GadgetReboot/GR_555_Controller/README.md

# GR_555_Controller
Controlling 555's using digital pots over I2C
