GadgetReboot/GR_555_Controller/GR_555_Controller_Sch.pdf

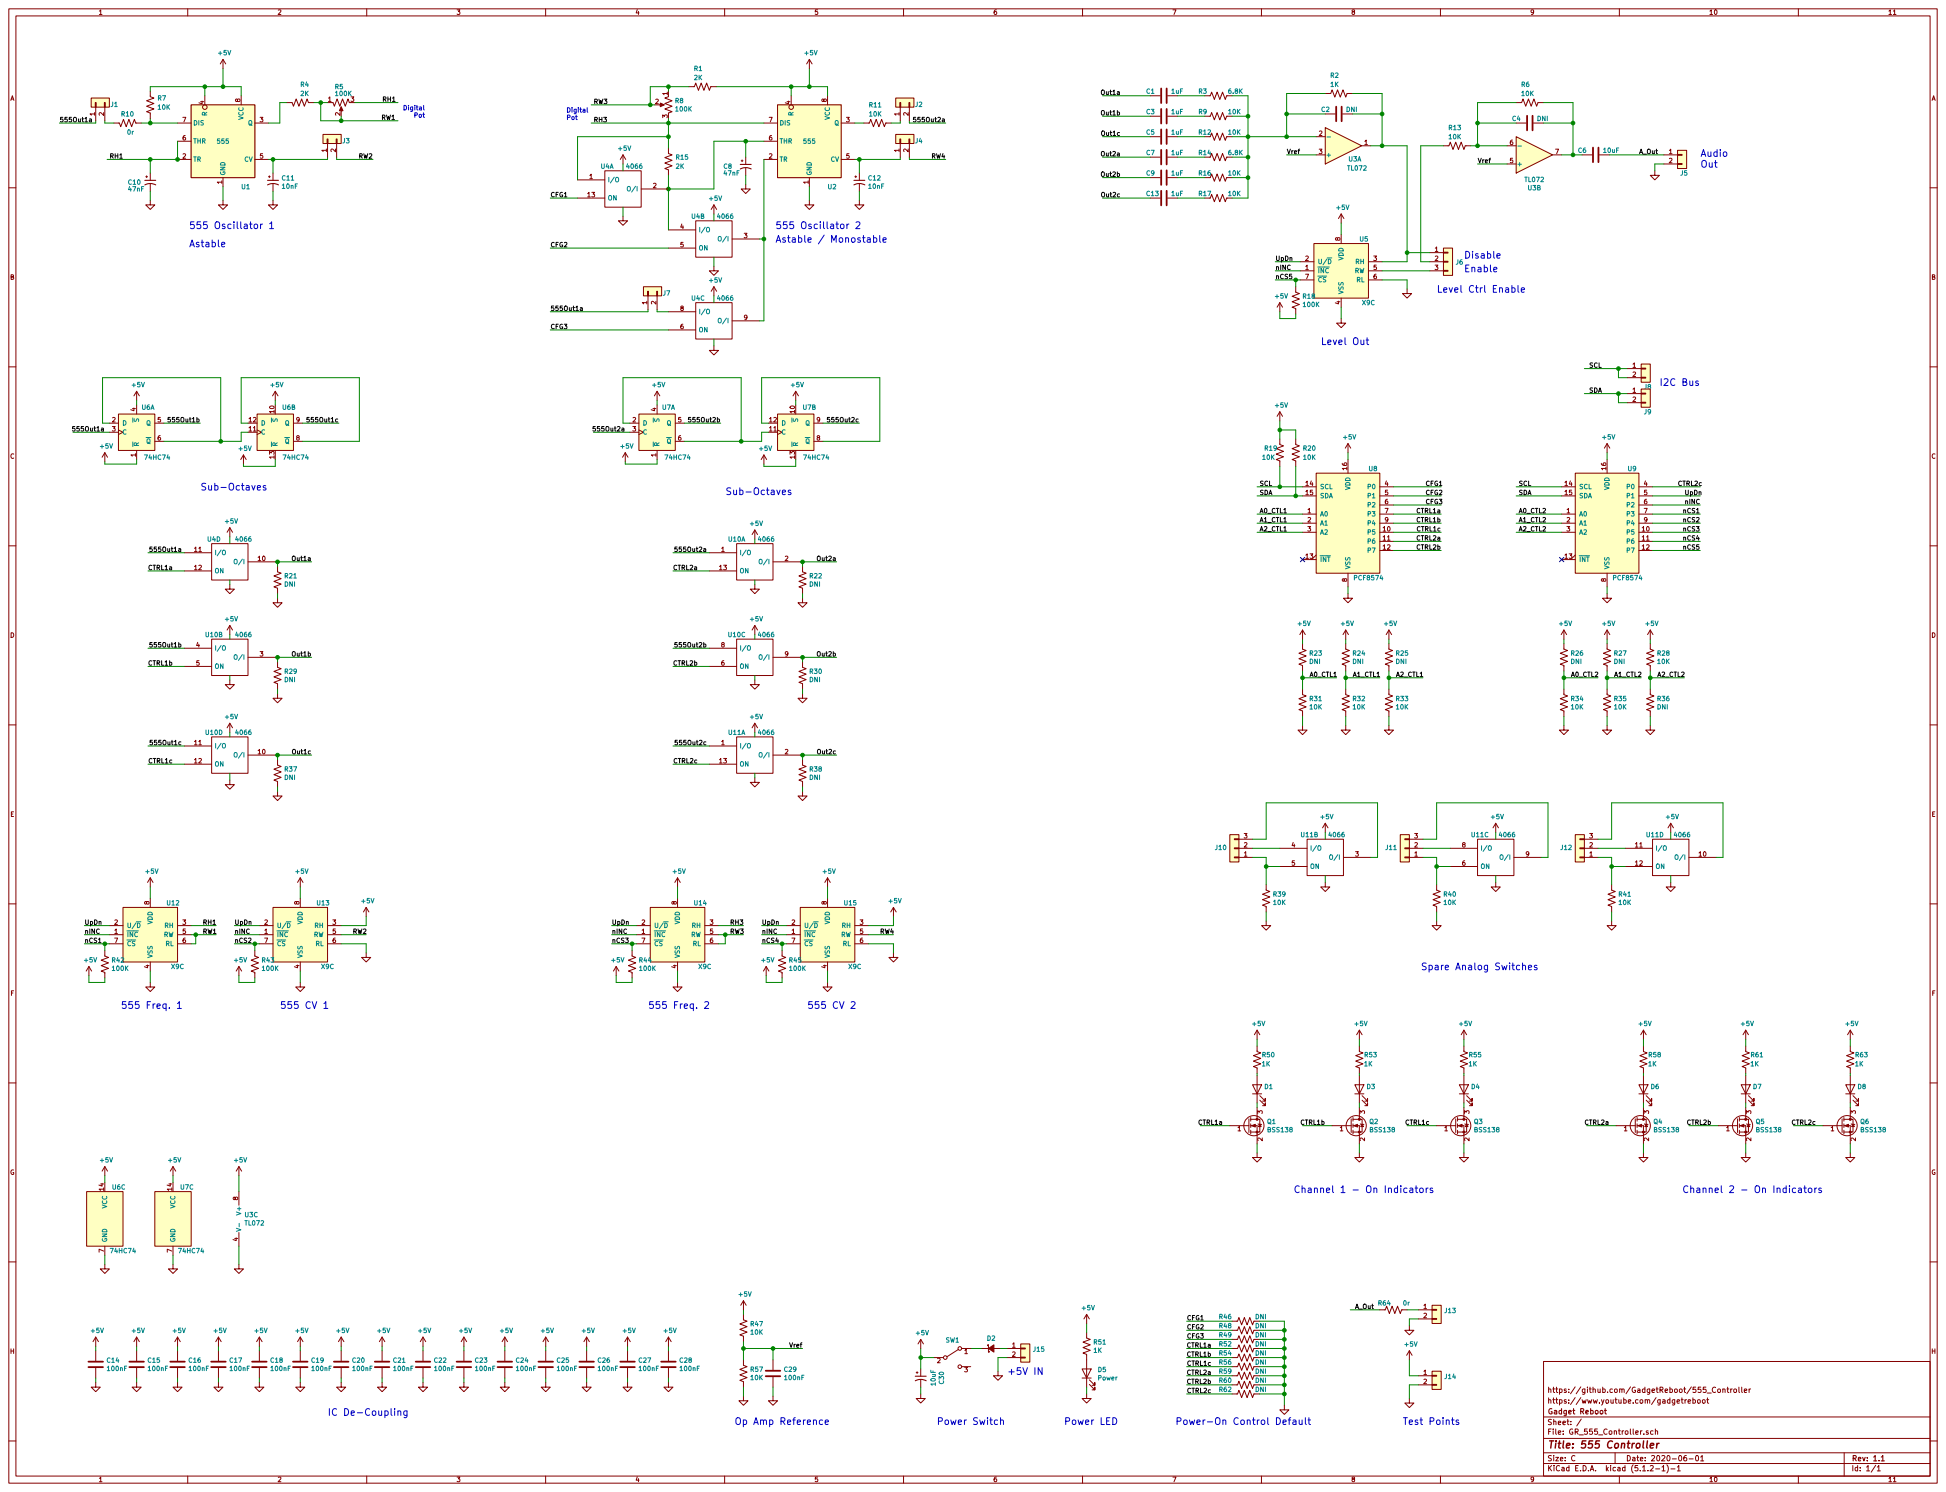
[picture p1: page 1]

4 RW 5 RL 6 CS 7 VDD

https://github.com/GadgetReboot/555_Controller R51
1KD5Power

https://www.youtube.com/gadgetreboot
File: GR_555_Controller.sch Sheet: / Gadget Reboot
