GadgetReboot/GR_555_Controller/KiCAD/GR_555_Controller.kicad_pcb

## KiCad design KiCAD/GR_555_Controller.kicad_pcb (2020-06-03)

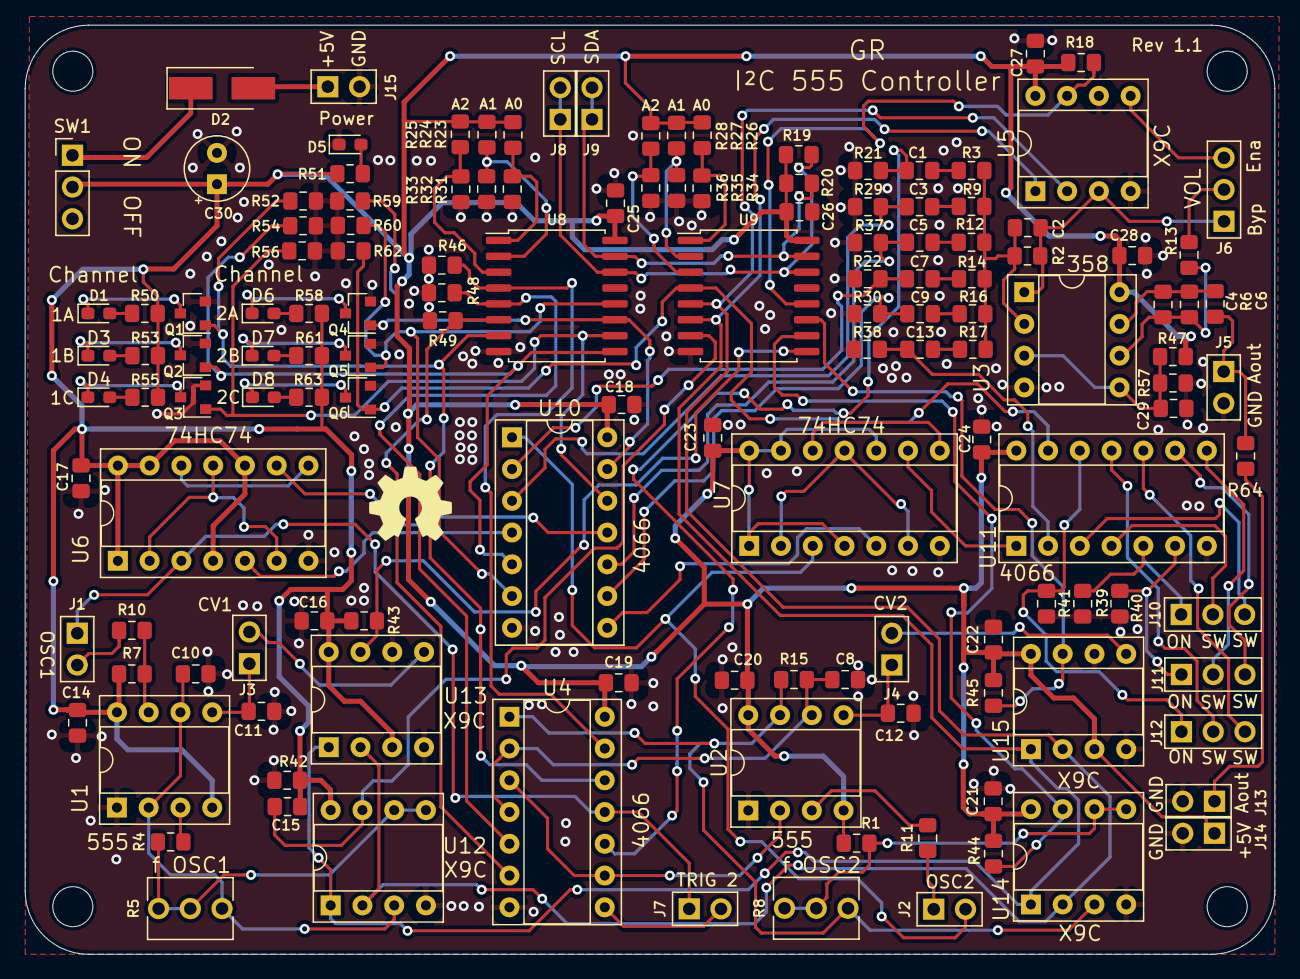
[picture p2: board GR_555_Controller.kicad_pcb from above]

Board: 2 copper layers, 99.9 x 74.3 mm, 139 parts (0 on the bottom side), 97 nets.

Parts:
C1, C3, C5, C7, C9, C13: 1uF; C_0805_2012Metric_Pad1.15x1.40mm_HandSolder
C2, C4: DNI; C_0805_2012Metric_Pad1.15x1.40mm_HandSolder
C6: 10uF; C_0805_2012Metric_Pad1.15x1.40mm_HandSolder
C8, C10: 47nF; C_0805_2012Metric_Pad1.15x1.40mm_HandSolder
C11, C12: 10nF; C_0805_2012Metric_Pad1.15x1.40mm_HandSolder
C14, C15, C16, C17, C18, C19, C20, C21, C22, C23, C24, C25, C26, C27, C28, C29: 100nF; C_0805_2012Metric_Pad1.15x1.40mm_HandSolder
C30: 10uF; CP_Radial_Tantal_D5.0mm_P2.50mm
D1, D3, D4, D6, D7, D8: LED; LED_0603_1608Metric_Pad1.05x0.95mm_HandSolder
D2: D_Schottky_Small_ALT; D_SMA_Handsoldering
D5: Power; LED_0603_1608Metric_Pad1.05x0.95mm_HandSolder
J1, J2, J3, J4, J5, J7, J8, J9, J13, J14, J15: 1x2; PinHeader_1x02_P2.54mm_Vertical_H1.0mm
J6, J10, J11, J12: Conn_01x03; PinHeader_1x03_P2.54mm_Vertical_H1.0mm
Q1, Q2, Q3, Q4, Q5, Q6: BSS138; SOT-23
R1, R4, R15: 2K; R_0805_2012Metric_Pad1.15x1.40mm_HandSolder
R2, R50, R51, R53, R55, R58, R61, R63: 1K; R_0805_2012Metric_Pad1.15x1.40mm_HandSolder
R3, R14: 6.8K; R_0805_2012Metric_Pad1.15x1.40mm_HandSolder
R5, R8: 100K; Potentiometer_Green
R6, R7, R9, R11, R12, R13, R16, R17, R19, R20, R28, R31, R32, R33, R34, R35, R39, R40, R41, R47, R57: 10K; R_0805_2012Metric_Pad1.15x1.40mm_HandSolder
R10, R64: 0r; R_0805_2012Metric_Pad1.15x1.40mm_HandSolder
R18, R42, R43, R44, R45: 100K; R_0805_2012Metric_Pad1.15x1.40mm_HandSolder
R21, R22, R23, R24, R25, R26, R27, R29, R30, R36, R37, R38, R46, R48, R49, R52, R54, R56, R59, R60, R62: DNI; R_0805_2012Metric_Pad1.15x1.40mm_HandSolder
SW1: SW_SPDT; PinHeader_1x03_P2.54mm_Vertical
U1, U2: 555; DIP-8_W7.62mm_Socket
U3: TL072; DIP-8_W7.62mm_Socket
U4, U10, U11: 4066; DIP-14_W7.62mm_Socket
U5, U12, U13, U14, U15: X9C; DIP-8_W7.62mm_Socket
U6, U7: 74HC74; DIP-14_W7.62mm_Socket
U8, U9: PCF8574; SOIC-16W_7.5x10.3mm_P1.27mm

Connections:
+5V: C14.1, C15.1, C16.1, C17.1, C18.1, C19.1, C20.1, C21.1, C22.1, C23.1, C24.1, C25.1, C26.1, C27.1, C28.1, C30.1, J14.1, R1.1, R7.1, R18.2, R19.1, R20.1, R23.1, R24.1, R25.1, R26.1, R27.1, R28.1, R42.2, R43.2, R44.2, R45.2, R47.1, R50.2, R51.1, R53.2, R55.2, R58.2, R61.2, R63.2, SW1.2, U1.4, U1.8, U2.4, U2.8, U3.8, U4.14, U5.8, U6.1, U6.4, U6.10, U6.13, U6.14, U7.1, U7.4, U7.10, U7.13, U7.14, U8.16, U9.16, U10.14, U11.14, U12.8, U13.3, U13.8, U14.8, U15.3, U15.8
/555Out1a: J1.1, J7.1, U4.11, U6.3
/555Out1b: U6.5, U10.4
/555Out1c: U6.9, U10.11
/555Out2a: J2.2, U7.3, U10.1
/555Out2b: U7.5, U10.8
/555Out2c: U7.9, U11.1
/A0_CTL1: R23.2, R31.1, U8.1
/A0_CTL2: R26.2, R34.1, U9.1
/A1_CTL1: R24.2, R32.1, U8.2
/A1_CTL2: R27.2, R35.1, U9.2
/A2_CTL1: R25.2, R33.1, U8.3
/A2_CTL2: R28.2, R36.1, U9.3
/A_Out: C6.1, J5.1, R64.2
/CFG1: R46.2, U4.13, U8.4
/CFG2: R48.2, U4.5, U8.5
/CFG3: R49.2, U4.6, U8.6
/CTRL1a: Q1.1, R52.2, U4.12, U8.7
/CTRL1b: Q2.1, R54.2, U8.9, U10.5
/CTRL1c: Q3.1, R56.2, U8.10, U10.12
/CTRL2a: Q4.1, R59.2, U8.11, U10.13
/CTRL2b: Q5.1, R60.2, U8.12, U10.6
/CTRL2c: Q6.1, R62.2, U9.4, U11.13
/Out1a: C1.2, R21.1, U4.10
/Out1b: C3.2, R29.1, U10.3
/Out1c: C5.2, R37.1, U10.10
/Out2a: C7.2, R22.1, U10.2
/Out2b: C9.2, R30.1, U10.9
/Out2c: C13.2, R38.1, U11.2
/RH1: C10.1, R5.3, U1.2, U1.6, U12.3
/RH3: R8.3, R15.1, U2.7, U4.1, U14.3
/RW1: R4.2, R5.1, R5.2, U12.5, U12.6
/RW2: J3.2, U13.5
/RW3: R1.2, R8.1, R8.2, U14.5, U14.6
/RW4: J4.2, U15.5
/SCL: J8.1, J8.2, R19.2, U8.14, U9.14
/SDA: J9.1, J9.2, R20.2, U8.15, U9.15
/UpDn: U5.2, U9.5, U12.2, U13.2, U14.2, U15.2
/Vref: C29.1, R47.2, R57.1, U3.3, U3.5
/nCS1: R42.1, U9.7, U12.7
/nCS2: R43.1, U9.9, U13.7
/nCS3: R44.1, U9.10, U14.7
/nCS4: R45.1, U9.11, U15.7
/nCS5: R18.1, U5.7, U9.12
/nINC: U5.1, U9.6, U12.1, U13.1, U14.1, U15.1
GND: C8.2, C10.2, C11.2, C12.2, C14.2, C15.2, C16.2, C17.2, C18.2, C19.2, C20.2, C21.2, C22.2, C23.2, C24.2, C25.2, C26.2, C27.2, C28.2, C29.2, C30.2, D5.1, J5.2, J13.2, J14.2, J15.2, Q1.2, Q2.2, Q3.2, Q4.2, Q5.2, Q6.2, R21.2, R22.2, R29.2, R30.2, R31.2, R32.2, R33.2, R34.2, R35.2, R36.2, R37.2, R38.2, R39.2, R40.2, R41.2, R46.1, R48.1, R49.1, R52.1, R54.1, R56.1, R57.2, R59.1, R60.1, R62.1, U1.1, U2.1, U3.4, U4.7, U5.4, U5.6, U6.7, U7.7, U8.8, U9.8, U10.7, U11.7, U12.4, U13.4, U13.6, U14.4, U15.4, U15.6
unnamed: C1.1, R3.2
unnamed: C2.1, J6.1, R2.1, U3.1, U5.3
unnamed: C2.2, R2.2, R3.1, R9.1, R12.1, R14.1, R16.1, R17.1, U3.2
unnamed: C3.1, R9.2
unnamed: C4.1, C6.2, R6.1, U3.7
unnamed: C4.2, R6.2, R13.1, U3.6
unnamed: C5.1, R12.2
unnamed: C7.1, R14.2
unnamed: C8.1, R15.2, U2.6, U4.2, U4.4
unnamed: C9.1, R16.2
unnamed: C11.1, J3.1, U1.5
unnamed: C12.1, J4.1, U2.5
unnamed: C13.1, R17.2
unnamed: D1.1, Q1.3
unnamed: D1.2, R50.1
unnamed: D2.1, SW1.1
unnamed: D2.2, J15.1
unnamed: D3.1, Q2.3
unnamed: D3.2, R53.1
unnamed: D4.1, Q3.3
unnamed: D4.2, R55.1
unnamed: D5.2, R51.2
unnamed: D6.1, Q4.3
unnamed: D6.2, R58.1
unnamed: D7.1, Q5.3
unnamed: D7.2, R61.1
unnamed: D8.1, Q6.3
unnamed: D8.2, R63.1
unnamed: J1.2, R10.1
unnamed: J2.1, R11.1
unnamed: J6.2, R13.2
unnamed: J6.3, U5.5
unnamed: J7.2, U4.8
unnamed: J10.1, R39.1, U11.5
unnamed: J10.2, U11.4
unnamed: J10.3, U11.3
unnamed: J11.1, R40.1, U11.6
unnamed: J11.2, U11.8
unnamed: J11.3, U11.9
unnamed: J12.1, R41.1, U11.12
unnamed: J12.2, U11.11
unnamed: J12.3, U11.10
unnamed: J13.1, R64.1
unnamed: R4.1, U1.3
unnamed: R7.2, R10.2, U1.7
unnamed: R11.2, U2.3
unnamed: U2.2, U4.3, U4.9
unnamed: U6.2, U6.6, U6.11
unnamed: U6.8, U6.12
unnamed: U7.2, U7.6, U7.11
unnamed: U7.8, U7.12
